bronsonp/LED-Shield/Hardware/Shield_PCB_BOM.xlsx

Comment | Description | Designator | Footprint | LibRef | Quantity | Suplier | Order Code
100uF, 50V | Electrolytic Capacitor, 100 µF, 50 V, ± 20%, Radial Leaded, 8 mm | C1 | Capacitor radial 8mm | Cap 100uF, 50V, THT radial | 1 | element14 | 1144634
CAP 1uF | CAP 1uF 25V ±10% 1206 (3216 Metric) Thickness 1.3mm SMD | C2 | CAPC1206(3216)130_M | CMP-1037-04700-1 | 1 | element14 | 1327717
LED3 | Typical BLUE SiC LED | D0, D1, D2, D3, D4, D5, D6, D7, D8, D9, D10, D11, D12, D13, D14, D15, D16, D17, D18, D19, D20, D21, D22, D23, D24, D25, D26, D27, D28, D29, D30, D31 | 3.5X2.8X1.9 | LED3 | 32 | element14 | 4134357 | 1830416RL | 1058419
Joystick | Sparkfun Joystick COM-09032 | J1, J2 | JOYSTICK | Joystick | 2 | https://www.digikey.com.au/product-detail/en/sparkfun-electronics/COM-09032/1568-1526-ND/6823623 | 1568-1526-ND
Resistor Axial-0.4 | Resistor | R1, R2 | AXIAL-0.4 | Resistor Axial-0.4 - 10k | 2 | element14 | 1128067
Res2 | Resistor | R3, R4 | AXIAL-0.4 | Resistor Axial-0.4 - 1K | 2 | element14 | 1127904
KMR231GLFS | Switch Tactile, SPST, 50 mA, 32 V, -40 to 85 degC, 4-Pin SMD, RoHS, Tape and Reel | SW1, SW2, SW3, SW4 | CKCP-KMR231GLFS | CMP-2000-06516-1 | 4 | element14 | 1437636
STP16CPC26XTR | ST Microelectronics STP16CPC26XTR constant current LED sink driver | U1, U2 | STP16CPC26XTR TSSOP-24 | LED sink driver 16 ch STP16CPC26XTR | 2 | element14 | 2762678
Arduino_Uno | Template for building an Arduino shield | U3 | ArduinoUnoR3 | Arduino_Uno | 1 | element14 | 2075382
 | Red LED
 | Blue LED
 | Green LED
