bronsonp/LED-Shield/Documentation/Schematic.pdf

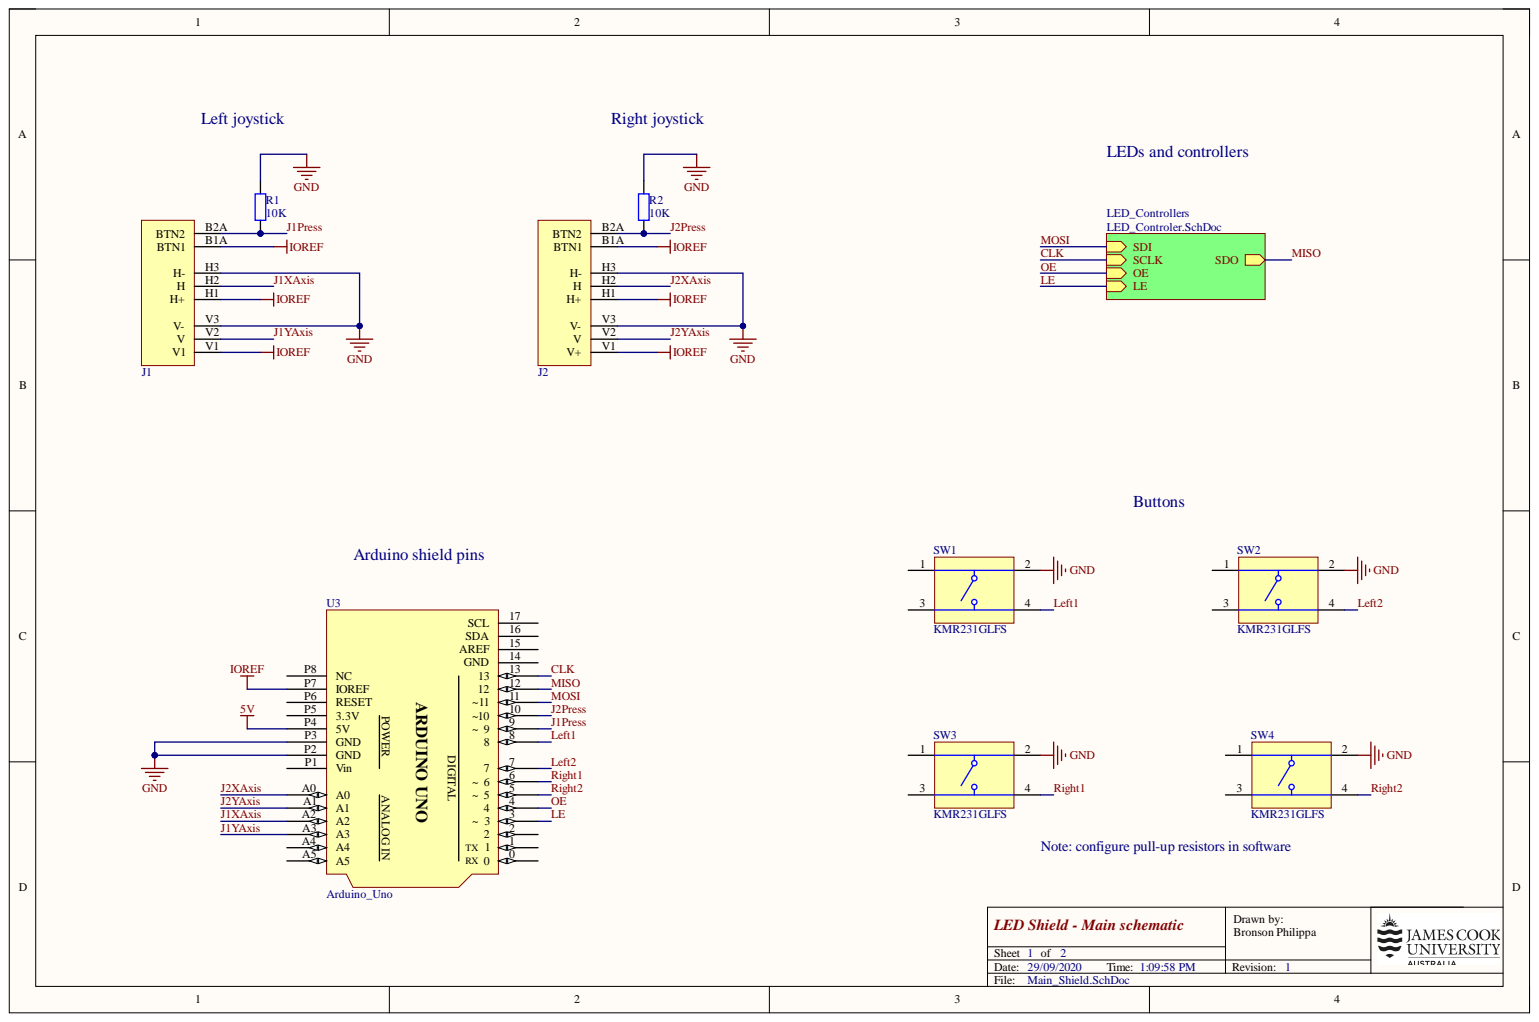
[picture p2: page 1]

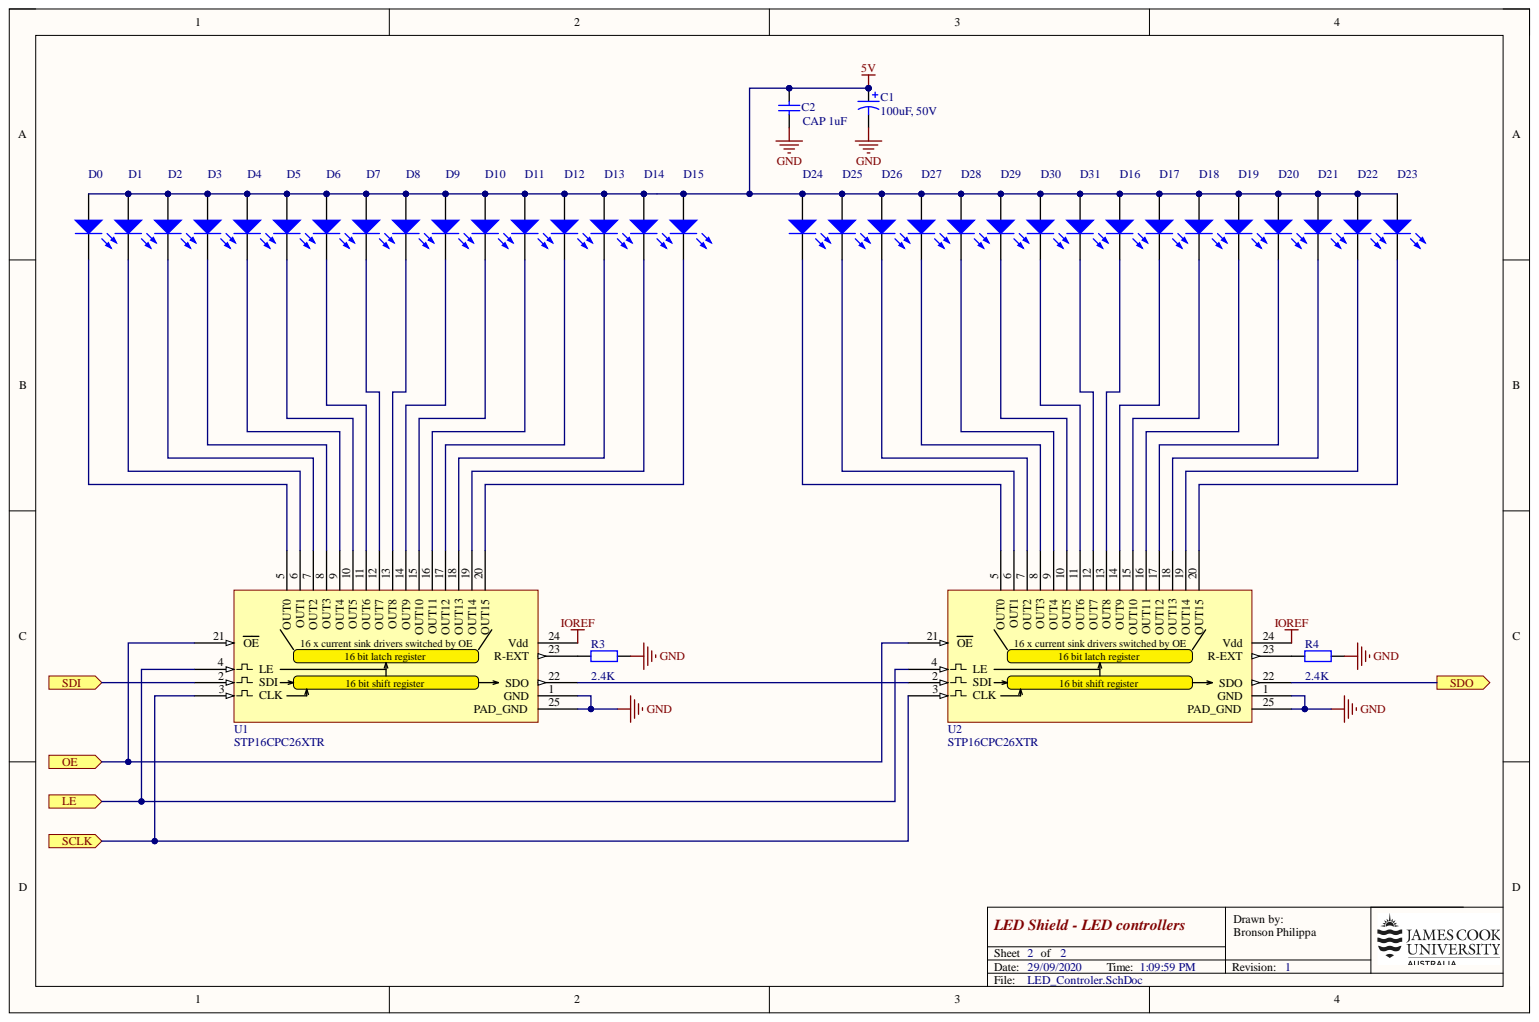
[picture p3: page 2]

16 x current sink drivers switched by OE

LED Shield - LED controllers

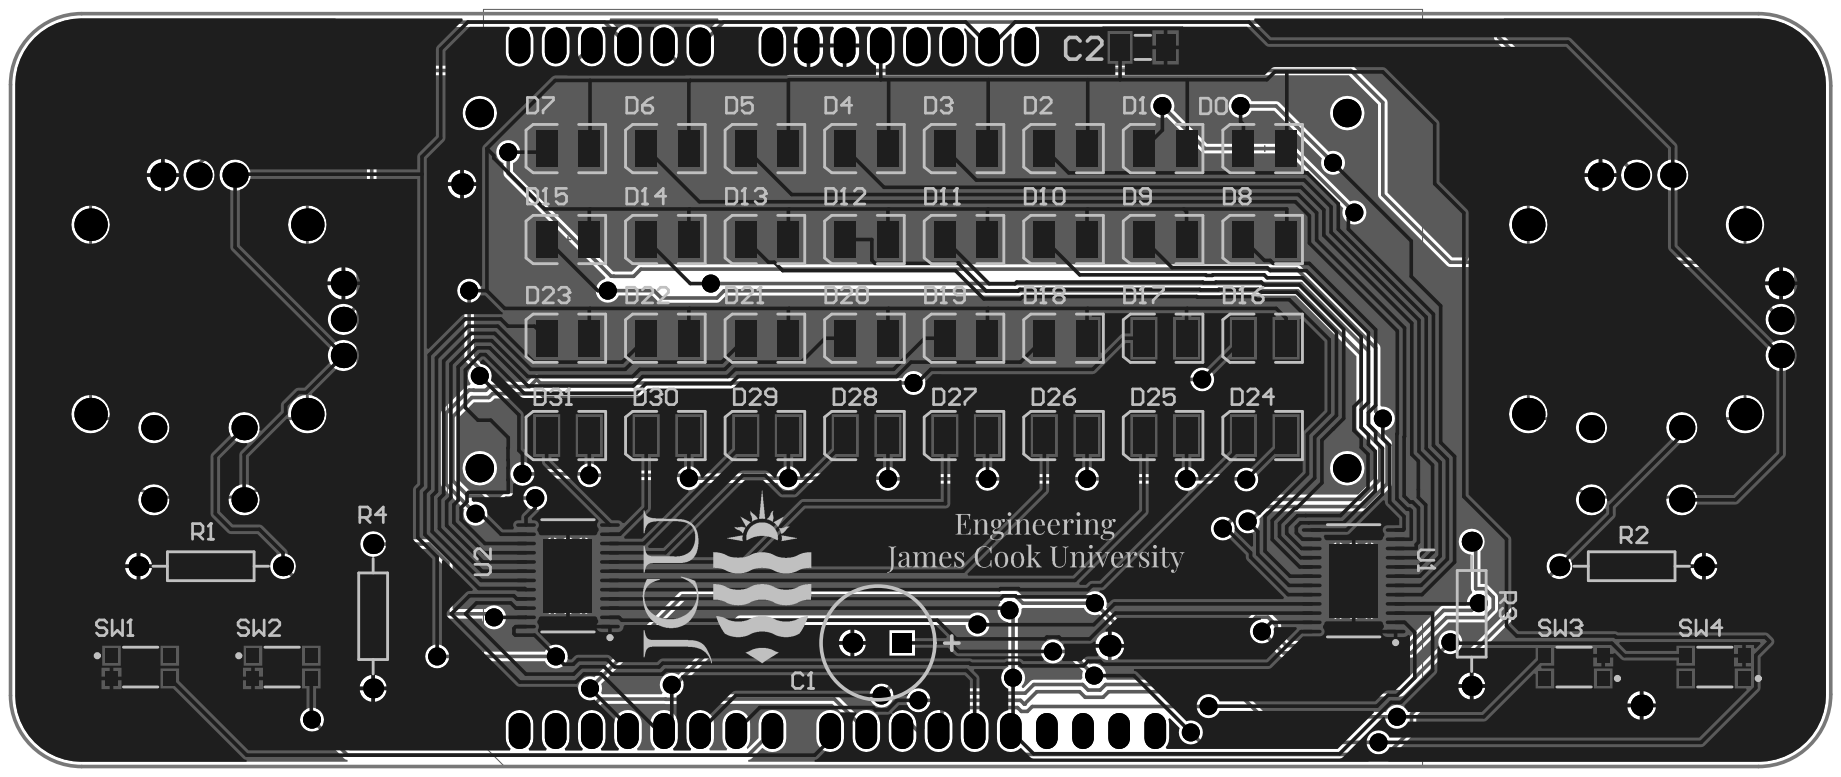
[picture p4: page 3]
