bronsonp/LED-Shield/(list of files, drawings)

Other design files:
Hardware/LED Shield.PrjPcb
Hardware/LED_Controler.SchDoc
Hardware/Main_Shield.SchDoc
Hardware/PCB Rev 1.PcbDoc
